RaphMad/SNESControl/compatibility/Legend of Zelda - A Link to the Past/readme.txt

*NOT* compatible

-> A Link to the Past seems to use some kind of RNG that is independent from button inputs.

Replays are frame perfect (capture files were taken on the wires to console by logic analyzer).

capture1.csv: Blue rupee from plant, kill 1st ogre (get hit by 1 bomb), cannot kill moblins
capture2.csv: Blue rupee from plant, kill 1st ogre (get hit by 1 bomb), kills both moblins
capture3.csv: same as capture2
capture4.csv: same result as previous, but moblins are killed differently (with charge)
capture5.csv: Blue rupee from plant, kill 1st ogre (get hit by 1 bomb), cannot kill moblins
