RaphMad/SNESControl/compatibility/Super Mario World/readme.txt

*COMPATIBLE*

-> replay.bin plays through levels 1+2

Replays are frame perfect (capture files were taken on the wires to console by logic analyzer).
