RaphMad/SNESControl/logic_captures/errors_to_analyze/02/readme.txt

Consistent error in replays on:

52.96s - Latch 2648 - Offset 10592
seems like the previous latch was still sampled - wait a bit?
