RaphMad/SNESControl/dump_scripts/lsnes/sample_converts/Super Mario World (U) - NTSC/masterjunv1-supermarioworld-executesarbitrarycode/readme.txt

Super Mario World NTSC

x) Works until the end, screen turns black when "data input phase" begins (executed via 8 multitap controllers, currently not possible with SNESControl)
