RaphMad/SNESControl/resources/projects_and_links.md

* NESBot: http://www.instructables.com/id/NESBot-Arduino-Powered-Robot-beating-Super-Mario-/
* Arduino SNES Controller Emulator: http://r.lagserv.net/snescontrolleremulator.htm
* snesbot: https://github.com/SonnyJim/snesbot
* SConE: https://github.com/jtrinklein/SConE
* NES Controller Interface with an Arduino UNO: https://www.allaboutcircuits.com/projects/nes-controller-interface-with-an-arduino-uno/
* nesdev.com Forum Post: https://forums.nesdev.com/viewtopic.php?f=12&t=12413
* console-tas: https://github.com/pjgat09/console-tas
* TASLink: https://github.com/pjgat09/TASLink
