RaphMad/SNESControl/resources/snes_controller_circuit.md

Source: https://gamesx.com/wiki/doku.php?id=controls:nes_snes_controller

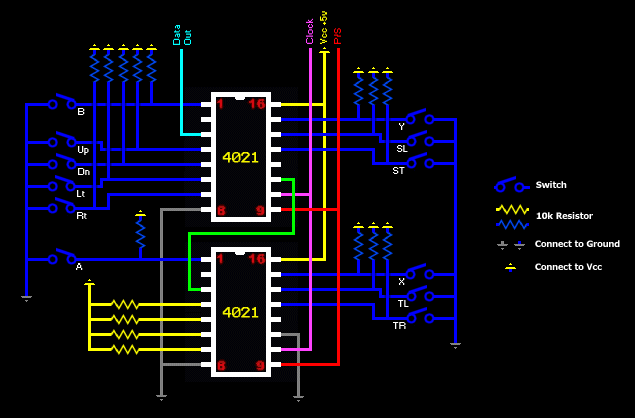
[picture p1: resources/snesnesicschem.gif]
