RaphMad/SNESControl/logic_captures/B+DOWN.png

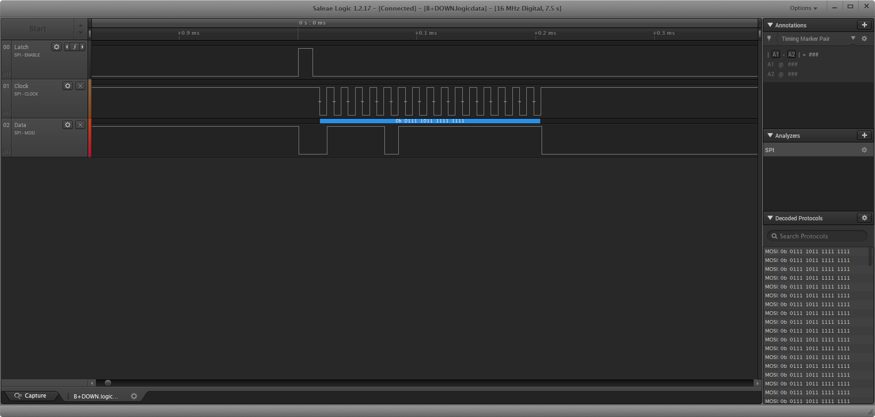
logic_captures/B+DOWN.png
