RaphMad/SNESControl/logic_captures/UP+SL.png

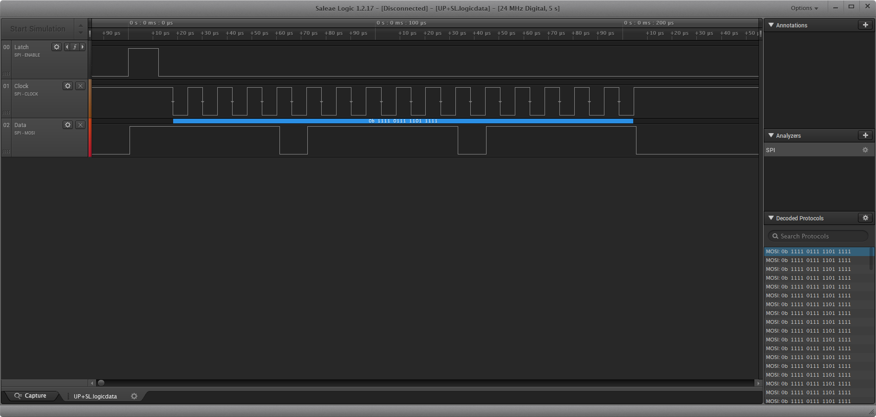
logic_captures/UP+SL.png
