RaphMad/SNESControl/schematics/schematic.png

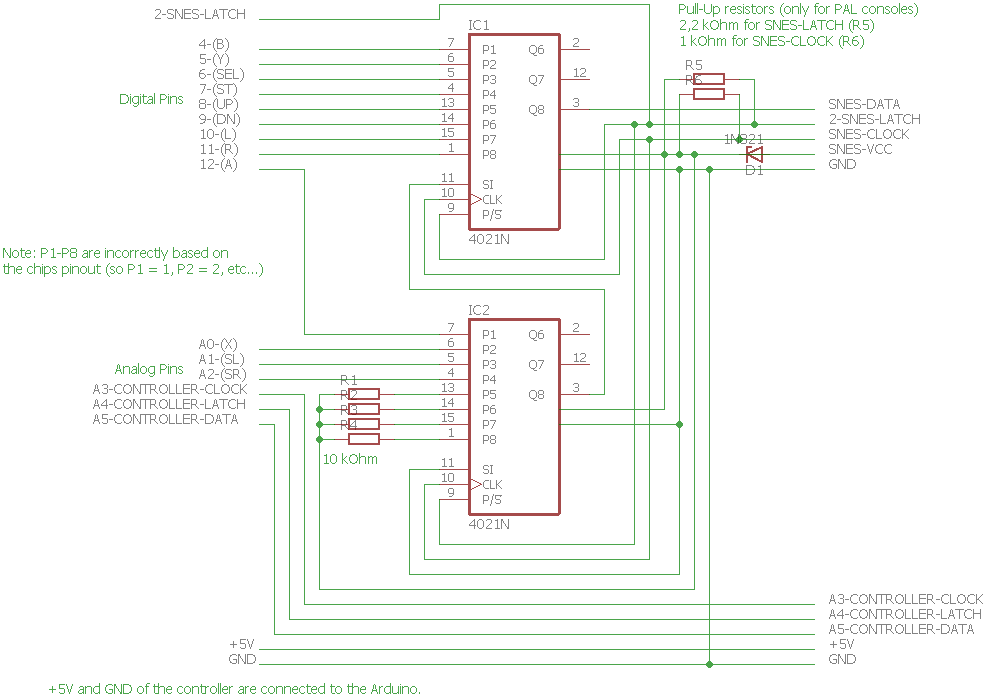
schematics/schematic.png
