RaphMad/SNESControl/schematics/schematic.sch

## EAGLE design schematics/schematic.sch (2018-01-29)

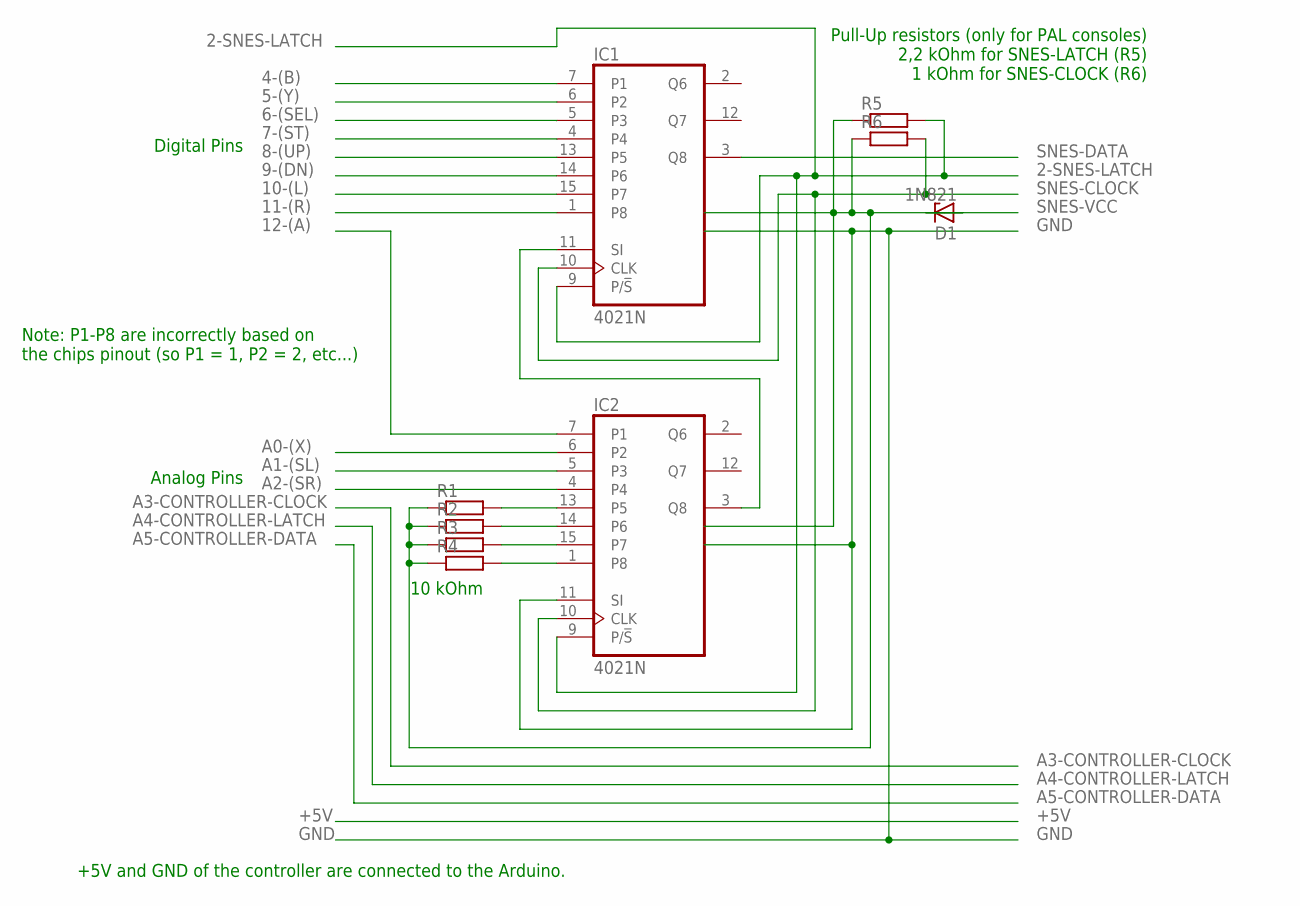
[picture p5: schematic schematic.sch]

Parts:
D1: 1N821; DO35Z10
IC1, IC2: 4021N; DIL16
R1, R2, R3, R4, R5, R6: R-EU_0204/2V; 0204V

Connections:
2-SNES-LATCH: IC1.9 (P/!S), IC2.9 (P/!S), R5.2
4-(B): IC1.7 (P1)
12-(A): IC2.7 (P1)
A0-(X): IC2.6 (P2)
A1-(SL): IC2.5 (P3)
A2-(SR): IC2.4
GND: IC2.11 (SI)
unnamed: IC2.13 (P5), R1.2
unnamed: IC2.14 (P6), R2.2
unnamed: IC2.15 (P7), R3.2
unnamed: IC2.1 (P8), R4.2
unnamed: IC1.11 (SI), IC2.3 (Q8)
SNES-CLOCK: IC1.10 (CLK), IC2.10 (CLK), R6.2
SNES-DATA: IC1.3 (Q8)
SNES-VCC: D1.A, R1.1, R2.1, R3.1, R4.1, R5.1, R6.1

Notes on the sheet:
Digital Pins
Analog Pins
10 kOhm
Pull-Up resistors (only for PAL consoles) 2,2 kOhm for SNES-LATCH (R5) 1 kOhm for SNES-CLOCK (R6)
+5V and GND of the controller are connected to the Arduino.
Note: P1-P8 are incorrectly based on the chips pinout (so P1 = 1, P2 = 2, etc...)
