RaphMad/SNESControl/arduino_code/src/ReadController/ReadController.h

#ifndef ReadController_h
#define ReadController_h

#include "common.h"

class ReadController {
    public:
        void begin() const;

        /*
         * Poll controller for data.
         */
        ButtonData getData() const;
};

extern ReadController ControllerReader;

#endif
