RaphMad/SNESControl/(commit log)

2018-01-24 Added schematic image
2018-01-24 Do not use pin 13 - reserved for LED
    [schematic.sch]
2018-01-26 Renamed folder to 'schematics'
    [schematic.sch]
2018-01-26 Updated schematic - connect latch to arduino
    [schematic.sch]
2018-01-26 Changed pull-up resistor for LATCH to 2,2kOhm
    [schematic.sch]
2018-01-26 Added sample capture for B+DOWN
2018-01-26 Updated schematic with controller input lines
    [schematic.sch]
2018-01-26 Implemented sending of pressed button states
2018-01-26 Fixed some brackets
2018-01-26 Added info that +5V and GND of controller are connected to the Arduino
    [schematic.sch]
2018-01-27 Updated Arduino code.
2018-01-27 Fixed a bug when the middle of a frame has been received
2018-01-28 Implemented basic replay (still buggy)
    [Messenger.cpp, WriteToConsole.cpp, types.h]
2018-01-28 Print info about latch duration
2018-01-28 Updated schematic with common ground
    [schematic.sch]
2018-01-28 Added info about lag frames
2018-01-28 Control max message size from Arduino
2018-01-28 Added some error samples
    [replay.csv, replay2.csv, replay3.csv, replay4.csv, replay5.csv, save.csv]
2018-01-28 Added diode to prevent current from running back into the console
    [schematic.sch]
2018-01-29 Added note about incorrect pinout
    [schematic.sch]
2018-01-29 Added info about current free memory to info
2018-01-29 Allocate send buffer statically to have a more predictable memory footprint
2018-01-29 Fixed calculation of free RAM
    [Messenger.cpp]
2018-01-29 Use extern declaration for appInfo, do not return reference to temporary ButtonData.
2018-01-29 Fixed conversion from ButtonData to bytes
2018-01-29 Fixed saving of button data
2018-01-30 Changed ButtonData to bit field
2018-01-30 Optimized types of ButtonData and AppInfo structures
2018-01-30 Extracted proper C++ class, refactored pin setting to directly work with port registers
2018-01-31 Changed pin definition to an enum
2018-01-31 Revert to uint16_t - uint8_t can become signed on subraction
    [main.cpp]
2018-01-31 Set output pins in an atomic action, extracted constants for pin masks
2018-01-31 Added another consistent error scenario
    [replay1.csv, replay2.csv, replay3.csv, save.csv]
2018-01-31 Poll controller between frames
2018-02-02 Added compatibility results for A Link to the Past
    [capture1.csv, capture2.csv, capture3.csv, capture4.csv, capture5.csv]
2018-02-02 Refactored usages, removed button time fixing
    [Messenger.h, ReadController.cpp, ReadController.h, WriteToConsole.h, common.h]
2018-02-03 Stop the builtin LED from lightning up
2018-02-03 Changed max content size to 32byte, so messages typically fit into the send/receive buffers after framing / error correction Removed send buffer
    [Messenger.cpp, Messenger.h, common.h]
2018-02-03 Fixed reading of button data
    [ReadController.cpp]
2018-02-03 Moved fix for built-in led to general setup
    [WriteToConsole.cpp, main.cpp]
2018-02-03 Added some prototype functions that may decode external replay file formats
2018-02-04 Store latch counter with button data
2018-02-05 Removed loop calculation and free RAM info, disabled interrupts
2018-02-05 Added compatibility results for Super Mario World
    [replay1.csv, replay2.csv, save.csv]
2018-02-05 Fixed writing to PORTC
    [WriteToConsole.cpp]
2018-02-05 Fixed "A" button
2018-03-07 Updated dump - automatically end when no more frames are available
2018-03-07 Added sample conversions
