RaphMad/SNESControl/(notices)

Notices in the files:
resources/Sci.Electronics FAQ_ Repair_ SNES Protocols.html:
TlJHdR HTML Markup 'Look and Feel' Copyright (c) 1993-1997
TlJHdR The whole section "About the Author and Copyright" MUST be
